kcorbett95/ECE-499-Capstone/CAD/608 bearing Wire Guide Assembly.step

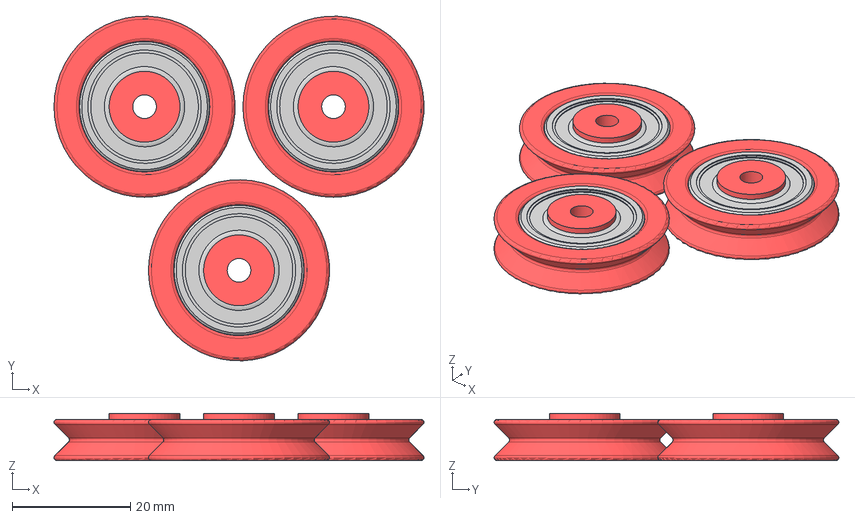
[picture p1: CAD file, 2026-08-06]
CAD/608 bearing Wire Guide Assembly.step
62.7 x 58.4 x 8.00 mm
5972K222_Steel Ball Bearing x 3
608 bearing wire guide x 3
