kcorbett95/ECE-499-Capstone/CAD/Coil Winder Assembly.step

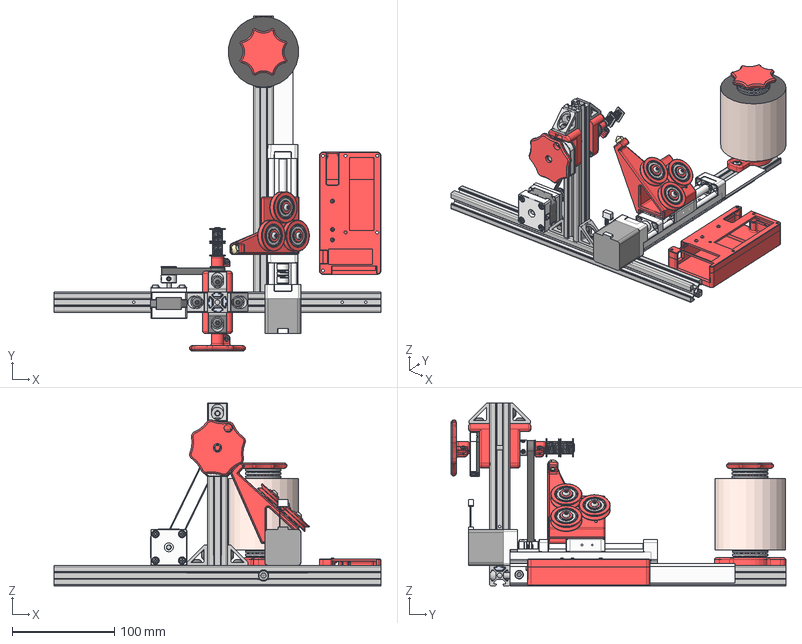
[picture p2: CAD file, 2026-08-06]
CAD/Coil Winder Assembly.step
320.0 x 327.5 x 178.7 mm
5537T518_T-Slotted Framing x 4
M5 2020 Drop Nut x 13
L Bracket
5972K222_Steel Ball Bearing x 2
8x88 shaft
BHCS M5 x 0.8 x 8 Steel Grade 2 Black x 7
¸´¼þ Áã¼þ4^FSK30J-BC- B35(A2°æ±¾£©
Áã¼þ3^FSK30J-BC-B35(A2°æ± ¾£©
76508.A x 2
BSHCS ANSI B18.3.1M - M4x0.7 x 6 Steel Grade 2 Plain x 3
BSHCS ANSI B18.3.1M - M5x0.8 x 8 Steel Grade 2 Plain x 3
BSHCS ANSI B18.3.1M - M6x1 x 20 Steel Grade 2 Plain
AMT-102-Base-REV-K
AMT-102-Top-Cover-REV-I
AMT-Hub-Top-REV-D1
AMT-Hub-Bottom-REV-B
AMT10X-Shaft-Adaptor-REV-E
Receiver-board
Rotor-board-REV F
Transmitter-board AMT10_AMT-102
3684N12_Corrosion-Resistant Aluminum Gt Timing Belt Pulley x 2
DIN 439-2 - M3 x 0.5 Steel 6 Plain x 4
BSHCS ANSI B18.3.1M - M3x0.5 x 12 Steel Grade 2 Plain x 2
DIN 934 - M5 x 0.8 Steel 6 Plain x 2
Bobbin Mount
BSHCS ASME B18.3.1M - M3x0.5 x 6 Steel Grade 2 Plain x 2
Hand Crank
Wire Spool
7806K716_Thrust Ball Bearing x 2
Spool Holder Base
Spool Clamp Adjuster
BHSBHCS ASME B18.3.4M - M5 x 0.8 x 8 Steel Grade 2 Plain x 4
5972K222_Steel Ball Bearing_1 x 3
608 bearing wire guide x 3
Wire Guide Mount
OEI - M4 X 6.35 Stainless Steel Plain x 3
BHSBHCS ASME B18.3.4M - M4 x 0.7 x 12 Steel Grade 2 Plain x 3
BHSBHCS ASME B18.3.4M - M4 x 0.7 x 6 Steel Grade 2 Plain x 4
3695N111_3D Printer Nozzle
6627T39_Stepper Motor
Motor Mount
BSHCS ASME B18.3.1M - M3x0.5 x 8 Steel Grade 2 Plain x 4
280mm GT2 Belt
Enclosure V2
