kcorbett95/ECE-499-Capstone/CAD/Wire Spool Holder (Assembly).step

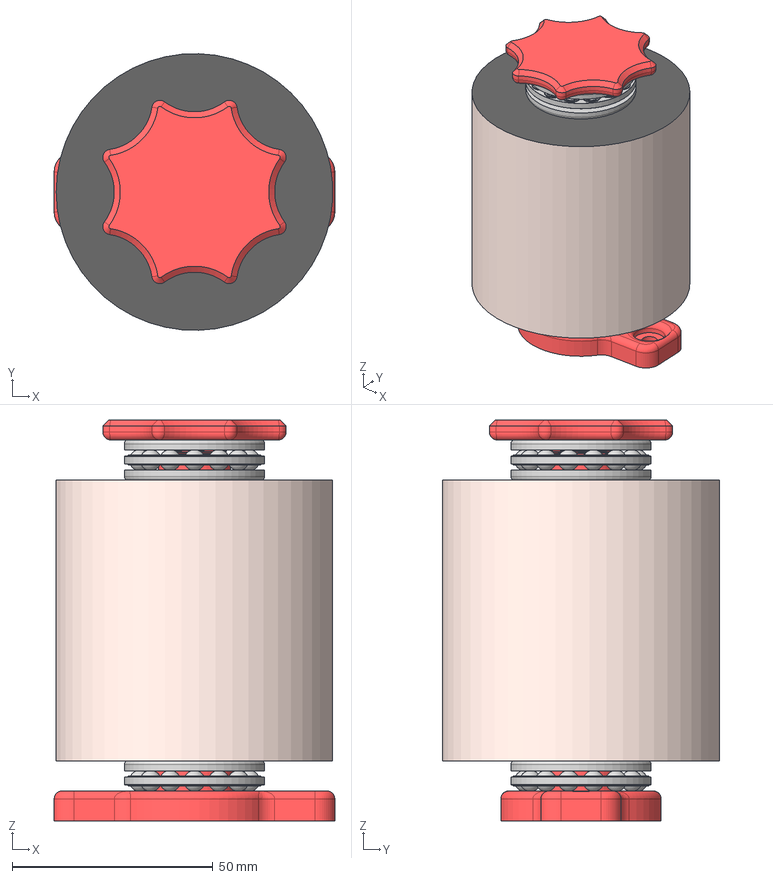
[picture p3: CAD file, 2026-08-06]
CAD/Wire Spool Holder (Assembly).step
70.0 x 69.0 x 100.0 mm
Wire Spool
7806K716_Thrust Ball Bearing x 2
Spool Holder Base
Spool Clamp Adjuster
