kcorbett95/ECE-499-Capstone/3d printed parts/Enclosure V2.3mf

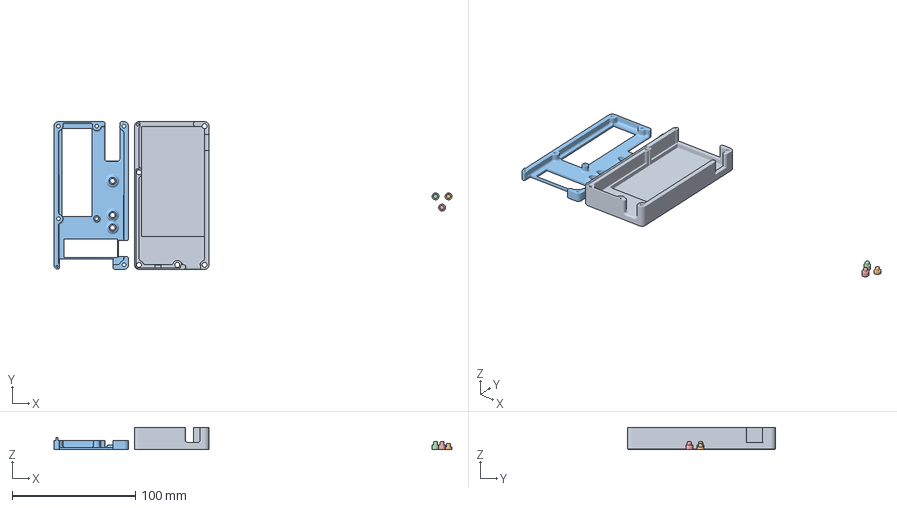
[picture p4: CAD file, 2026-08-06]
3d printed parts/Enclosure V2.3mf
322.4 x 119.6 x 18.2 mm
Bottom
Reset Btn
Top
Start Btn x 2
