kcorbett95/ECE-499-Capstone/CAD/Encoder Same_Sky_AMT102-0048-N2000-S.step

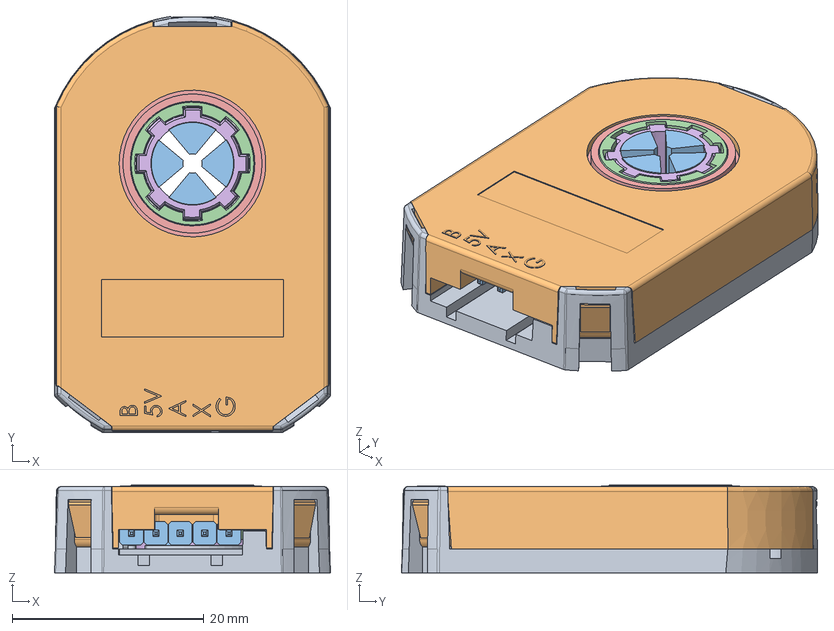
[picture p5: CAD file, 2026-08-06]
CAD/Encoder Same_Sky_AMT102-0048-N2000-S.step
28.8 x 43.4 x 9.15 mm
AMT-102-Base-REV-K
AMT-102-Top-Cover-REV-I
AMT-Sleeve-REV-D_ 2 mm
AMT-Hub-Top-REV-D1
AMT-Hub-Bottom-REV-B
AMT10X-Shaft-Adaptor-REV-E
Receiver-board
Rotor-board-REV F
Transmitter-board AMT10_AMT-102
