kcorbett95/ECE-499-Capstone/3d printed parts/Spool Holder-big-boi.3mf

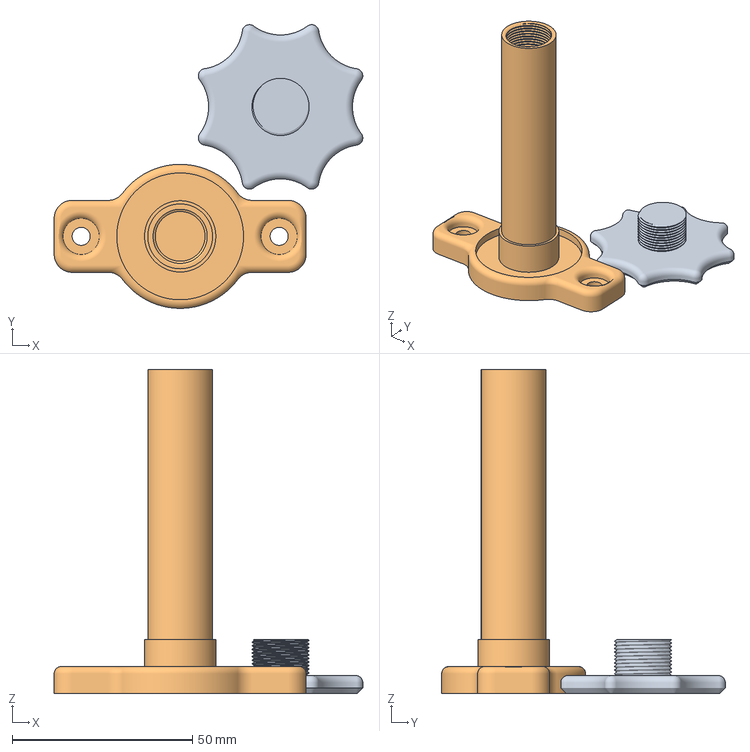
[picture p6: CAD file, 2026-08-06]
3d printed parts/Spool Holder-big-boi.3mf
85.7 x 78.8 x 90.0 mm
