kcorbett95/ECE-499-Capstone/CAD/Hand Crank.step

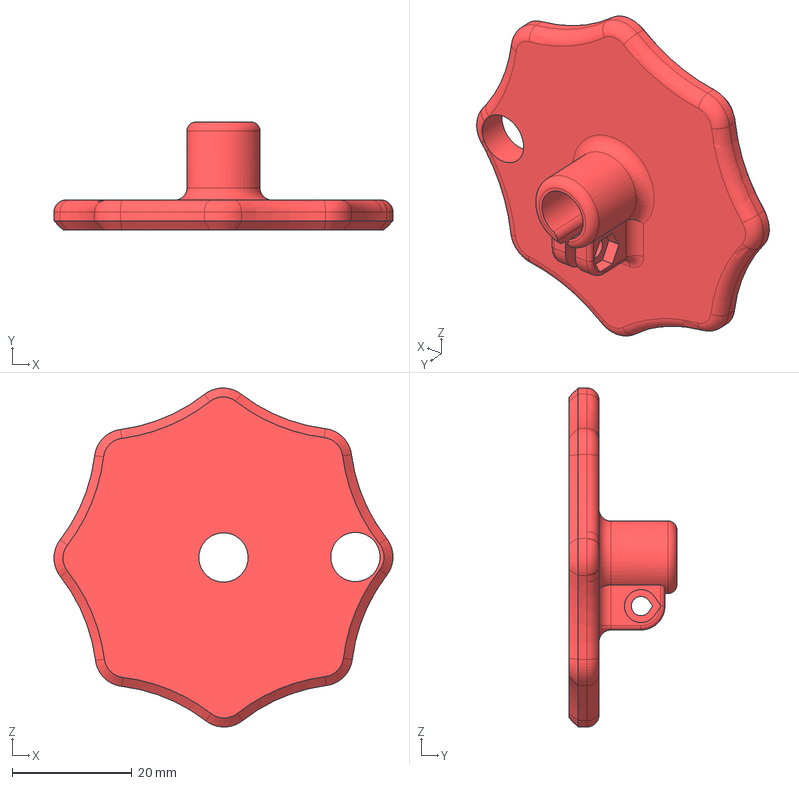
[picture p7: CAD file, 2026-08-06]
CAD/Hand Crank.step
56.5 x 18.0 x 56.5 mm
