kcorbett95/ECE-499-Capstone/3d printed parts/Spool Holder.3mf

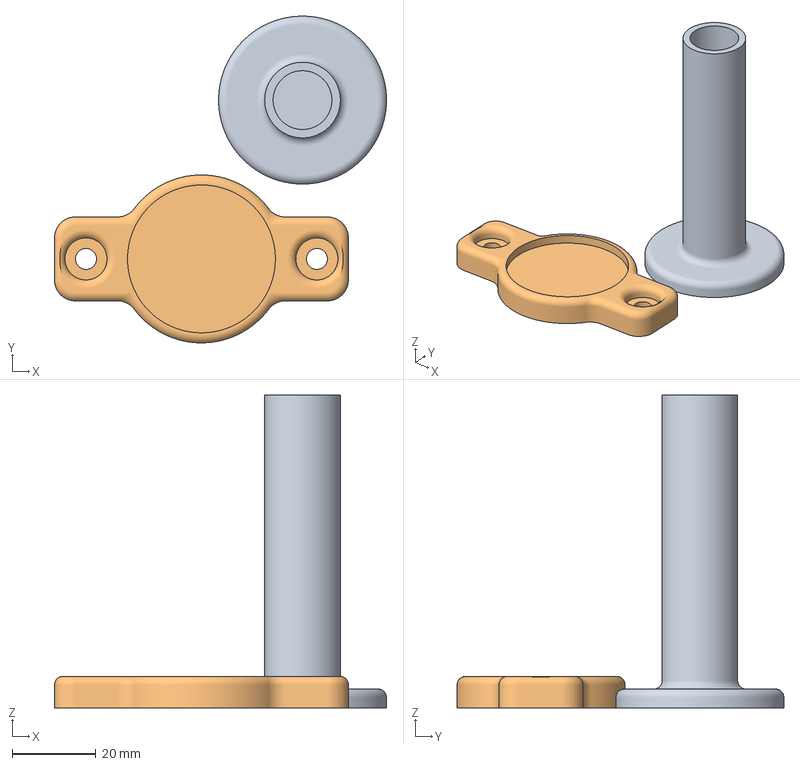
[picture p8: CAD file, 2026-08-06]
3d printed parts/Spool Holder.3mf
79.1 x 77.8 x 74.5 mm
