kcorbett95/ECE-499-Capstone/CAD/FSK30J-50mm.step

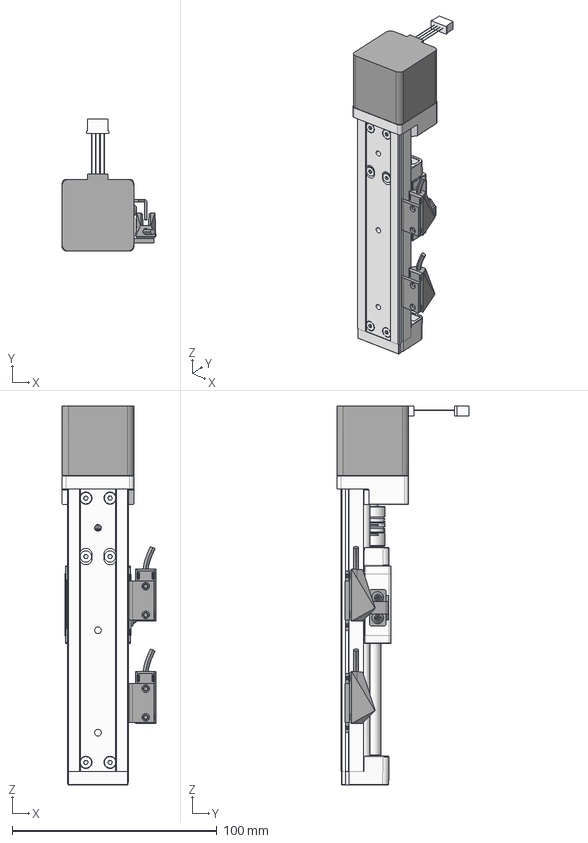
[picture p9: CAD file, 2026-08-06]
CAD/FSK30J-50mm.step
45.8 x 64.5 x 185.1 mm
复件 零件4^FSK30J-BC-B 35(A2版本）
复件 零件7^FSK30J-BC-B 35(A2版本） x 2
复件 零件9^FSK30J-BC-B 35(A2版本）
零件3^FSK30J-BC-B35(A2版本 ）
