kcorbett95/ECE-499-Capstone/3d printed parts/Tensioner.3mf

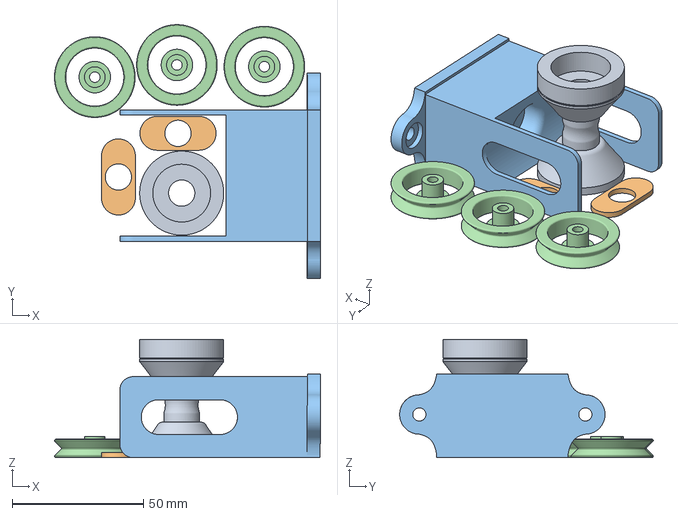
[picture p10: CAD file, 2026-08-06]
3d printed parts/Tensioner.3mf
101.3 x 96.6 x 45.0 mm
Assembly x 4
