kcorbett95/ECE-499-Capstone/CAD/Encoder Bearing Block.step

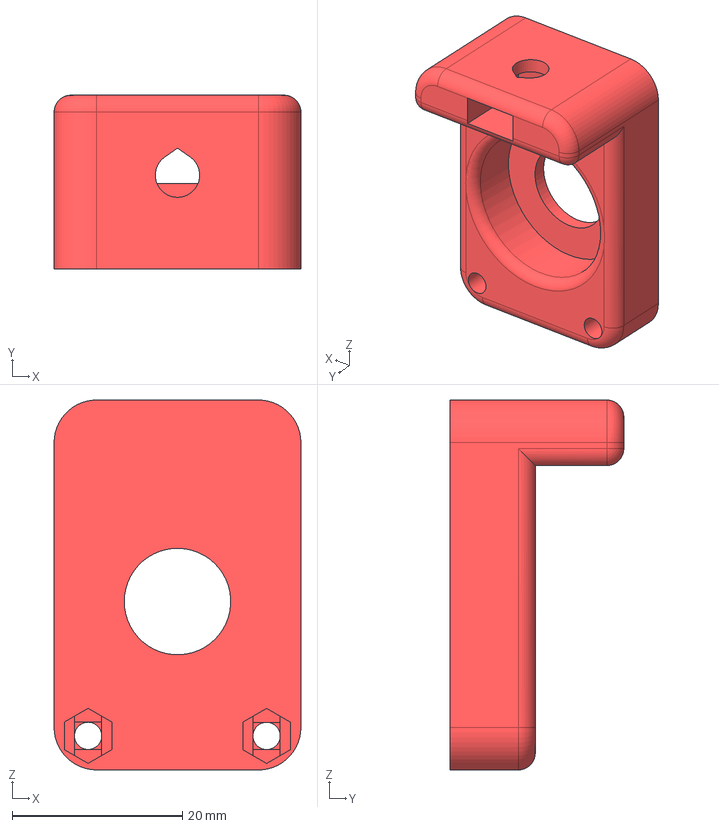
[picture p11: CAD file, 2026-08-06]
CAD/Encoder Bearing Block.step
29.0 x 20.4 x 43.5 mm
