kcorbett95/ECE-499-Capstone/CAD/Spool Clamp Adjuster.step

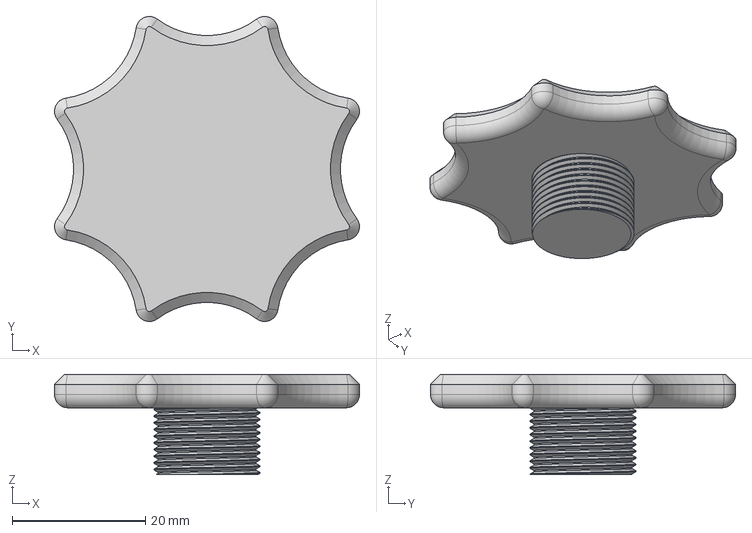
[picture p12: CAD file, 2026-08-06]
CAD/Spool Clamp Adjuster.step
45.7 x 45.7 x 15.0 mm
