kcorbett95/ECE-499-Capstone/CAD/Nozzle.step

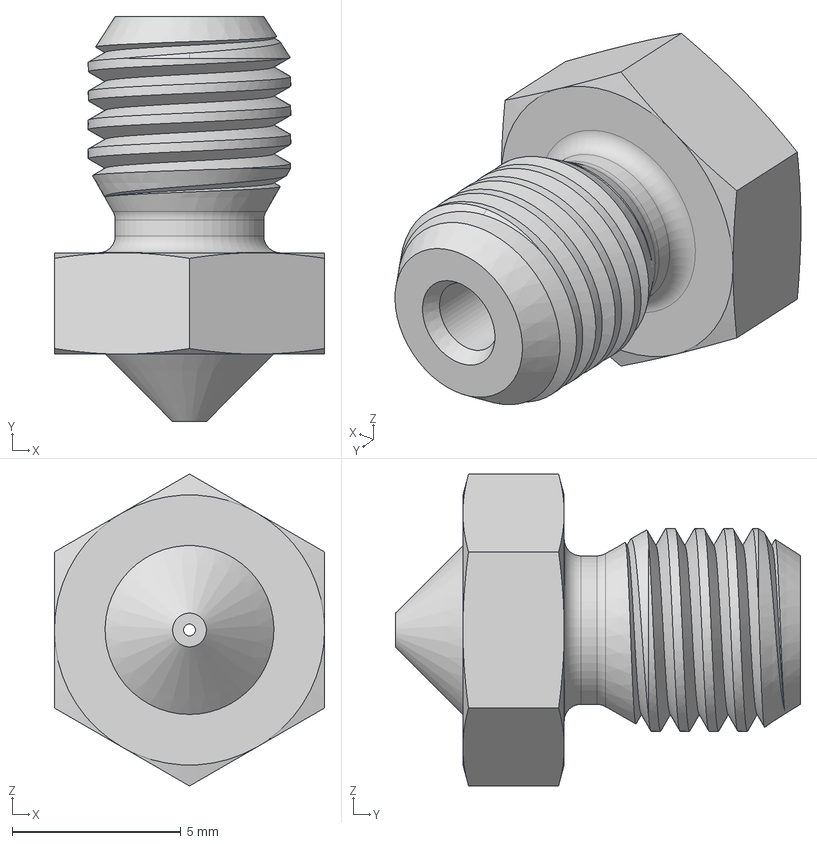
[picture p13: CAD file, 2026-08-06]
CAD/Nozzle.step
8.00 x 12.0 x 9.24 mm
