kcorbett95/ECE-499-Capstone/CAD/Long Wire Guide Mount.step

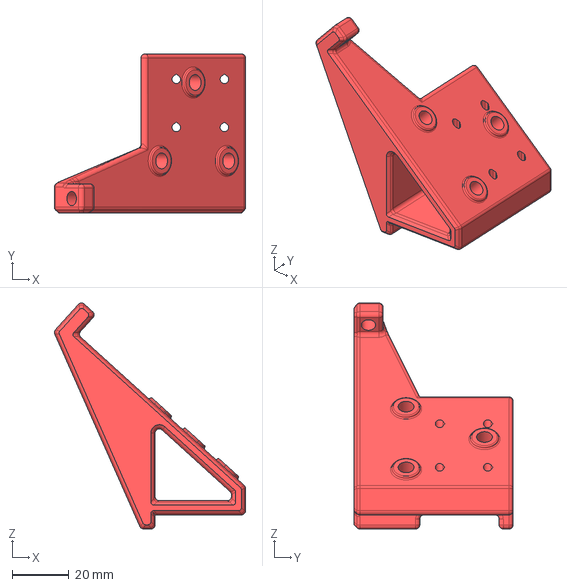
[picture p14: CAD file, 2026-08-06]
CAD/Long Wire Guide Mount.step
67.6 x 56.3 x 79.9 mm
