kcorbett95/ECE-499-Capstone/CAD/Spool Holder Base.step

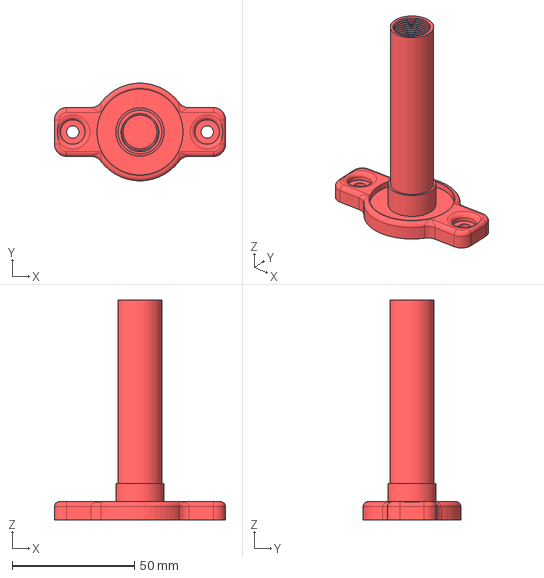
[picture p15: CAD file, 2026-08-06]
CAD/Spool Holder Base.step
70.0 x 39.9 x 90.0 mm
