kcorbett95/ECE-499-Capstone/CAD/Enclosure V2.step

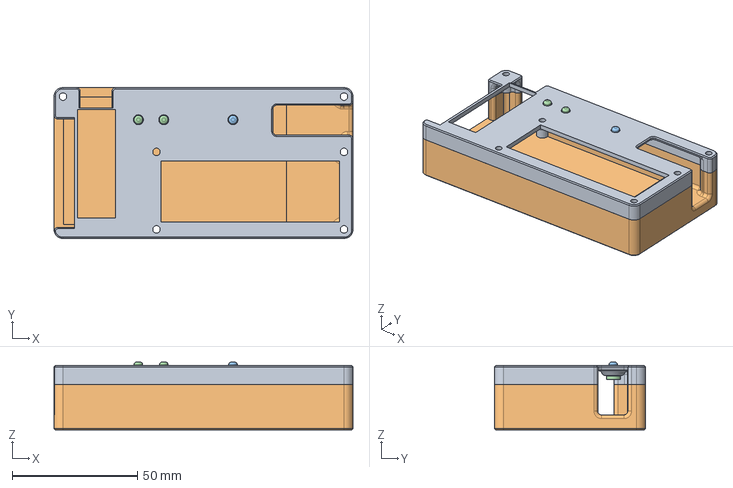
[picture p16: CAD file, 2026-08-06]
CAD/Enclosure V2.step
119.6 x 60.3 x 27.1 mm
