kcorbett95/ECE-499-Capstone/CAD/Bobbin Mount.step

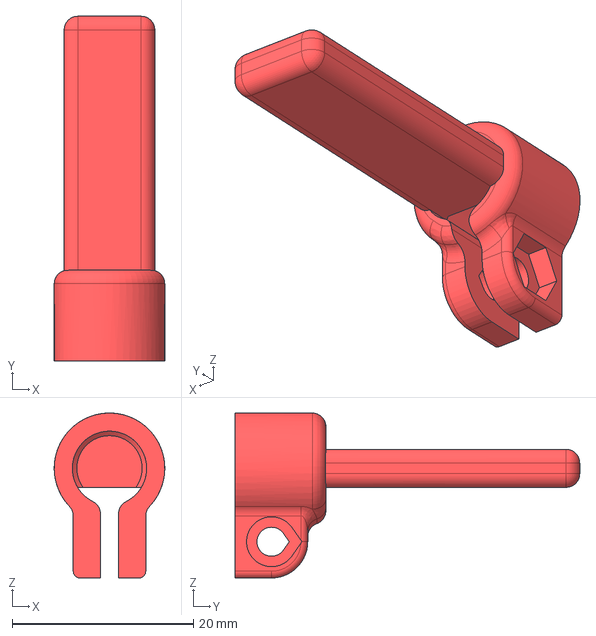
[picture p17: CAD file, 2026-08-06]
CAD/Bobbin Mount.step
12.2 x 38.0 x 18.2 mm
