kcorbett95/ECE-499-Capstone/(list of files, cad)

Other CAD files:
3d printed parts/bobbin.3mf
