kcorbett95/ECE-499-Capstone/PCB/PCB.kicad_pcb

## KiCad design PCB/PCB.kicad_pcb (2026-08-06)

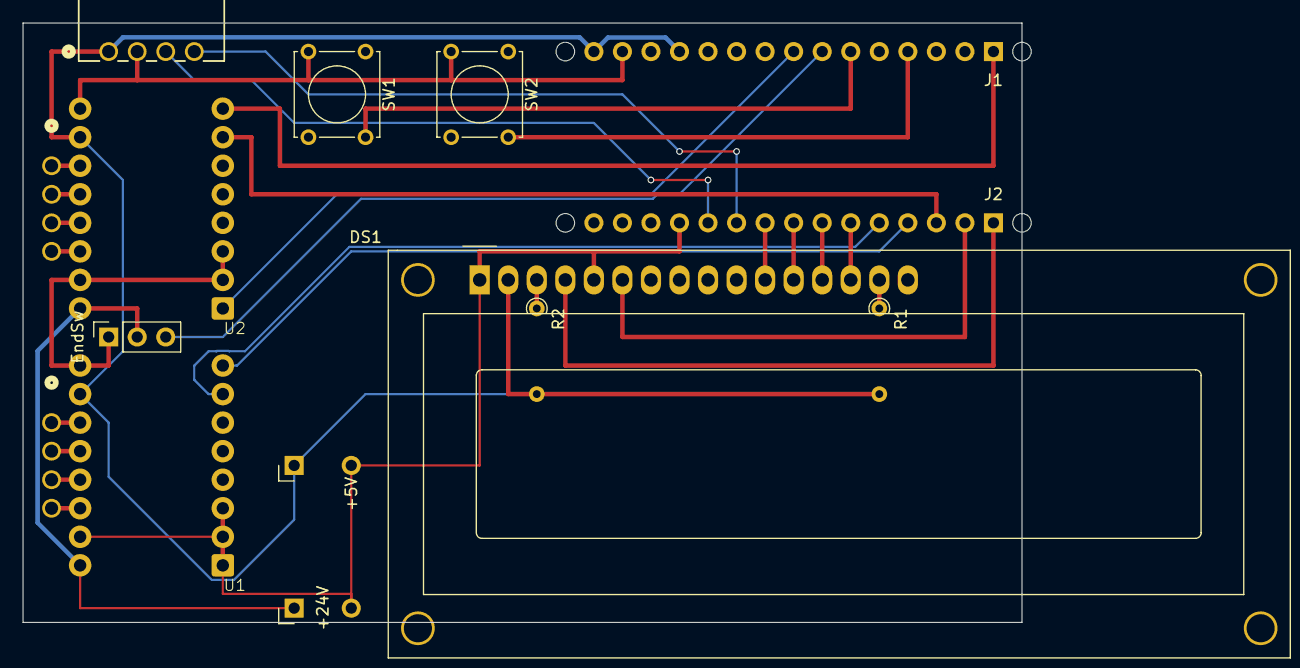
[picture p22: board PCB.kicad_pcb from above]

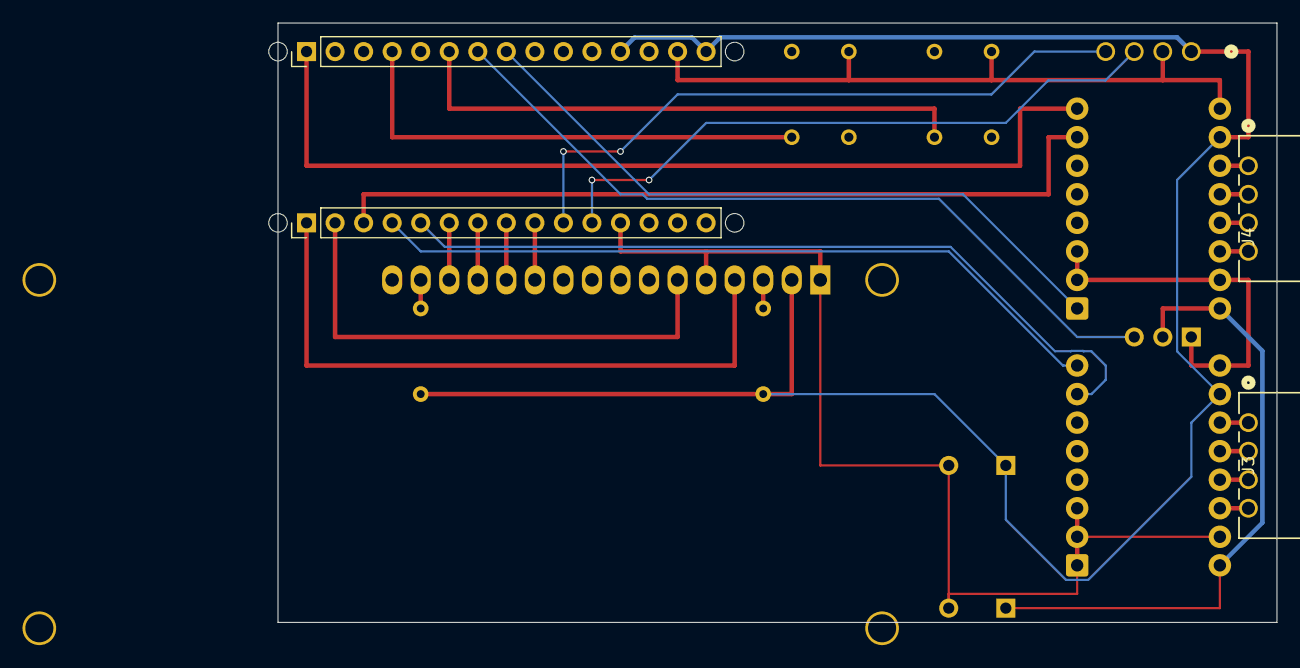
[picture p23: board PCB.kicad_pcb from below]

Board: 2 copper layers, 88.9 x 53.3 mm, 19 parts (4 on the bottom side), 30 nets.

Parts:
+5V, +24V: PinHeader_1x02_P2.54mm_Vertical
DS1: HY1602E; WC1602A
EndSw: PinSocket_1x03_P2.54mm_Vertical
J1: Analog; PinHeader_1x15_P2.54mm_Vertical
J2: Digital; PinHeader_1x15_P2.54mm_Vertical
J3, J4, J5: Conn_01x04_Pin; CONN_70553-xxxx_04_MOL
MH1, MH2, MH3, MH4: MountingHole_65mil
R1: 220; R_Axial_DIN0204_L3.6mm_D1.6mm_P1.90mm_Vertical
R2: 1k2; R_Axial_DIN0204_L3.6mm_D1.6mm_P1.90mm_Vertical
SW1, SW2: SW_DPST; SW_Tactile_Straight_KSL0Axx1LFTR
U1, U2: BTT-TMC2209

Connections:
+5V: +5V.1, DS1.2 (VDD), J1.12, J1.15, J5.1, R1.2, R2.2, U1.10 (VDD), U2.10 (VDD)
+24V: +24V.1, EndSw.2, U1.16 (VM), U2.16 (VM)
/*D3: J2.10, J5.4
/*D5: DS1.12 (D5), J2.8
/*D6: DS1.13 (D6), J2.7
/*D9: J2.4, U1.8 (DIR)
/*D10/SS: J2.3, U2.7 (STEP)
/*D11/MOSI: DS1.6 (E), J2.2
/A0: J1.4, SW2.1
/A2: J1.6, SW1.1
/A3: EndSw.3, J1.7
/A4/SDA: J1.8, U2.1 (EN)
/D2: J2.11, J5.3
/D4: DS1.11 (D4), J2.9
/D7: DS1.14 (D7), J2.6
/D8: J2.5, U1.7 (STEP)
/D12/MISO: DS1.4 (RS), J2.1
/D13/SCK: J1.1, U2.8 (DIR)
/~RESET: J1.13, J2.13
GND: +5V.2, +24V.2, DS1.1 (VSS), DS1.5 (R/W), DS1.16 (LED(-)), EndSw.1, J1.14, J2.12, J5.2, SW1.2, SW2.2, U1.1 (EN), U1.2 (MS1), U1.3 (MS2), U1.9 (GND), U1.15 (GND), U2.2 (MS1), U2.3 (MS2), U2.9 (GND), U2.15 (GND)
unnamed: DS1.15 (LED(+)), R1.1
unnamed: DS1.3 (VO), R2.1
unnamed: J3.1, U1.11 (B2)
unnamed: J3.2, U1.12 (B1)
unnamed: J3.3, U1.13 (A1)
unnamed: J3.4, U1.14 (A2)
unnamed: J4.1, U2.11 (B2)
unnamed: J4.2, U2.12 (B1)
unnamed: J4.3, U2.13 (A1)
unnamed: J4.4, U2.14 (A2)
