kcorbett95/ECE-499-Capstone/include/stepper.h

#ifndef stepper_h
#define stepper_h

/*
/   Stepper Controller Model: TMC2209
/   Pinout:
/       P0 = Enable
/       P1 = MS1 (MircoStep Resolution)
/       P2 = MS2 (MircoStep Resolution)
/       P3 = PDN
/       P4 = PDN
/       P5 = CLK (Tie to GND for internal clock)
/       P6 = STEP (Single Step Pulse)
/       P7 = DIR (Step Direction)
/       P8 = VM (Stepper Motor Reference Voltage 24V)
/       P9 = GND
/       P10 = Motor A2
/       P11 = Motor A1
/       P12 = Motor B1
/       P13 = Motor B2
/       P14 = Motor A2
/       P15 = VDD   (5V)
/       P16 = GND
/   MS1/2 Resolution:
/       00 = 1/8
/       01 = 1/32
/       10 = 1/64
/       11 = 1/16
/   0.01mm linear travel per step
/   LINEAR_RES 0.00106 measured per MicroStep with MS1/2 = 00
*/

#include <Arduino.h>

class stepper{
    public:

    stepper(int Step_Pin, int Direction_Pin){
        _stepPin = Step_Pin;
        _dirPin = Direction_Pin;
    }

    void enable(){
        pinMode(_stepPin, OUTPUT);
        pinMode(_dirPin, OUTPUT);
    }

    void step(int direction, int num_step){
        digitalWrite(_dirPin, direction ? HIGH : LOW);
        delayMicroseconds(5);
        for(int i = 0; i < num_step; i++){
            digitalWrite(_stepPin, HIGH);
            delayMicroseconds(160);
            digitalWrite(_stepPin, LOW);
            delayMicroseconds(160);
        }
    }

    private:
    int _stepPin;
    int _dirPin;
};

#endif
