kcorbett95/ECE-499-Capstone/(commit log)

2026-06-21 Encoder 1.0
    Encoder working with simple counter and revolution increment/decrement. Will improve functionality and tweak areas at a later point.
2026-06-21 Cleanup
    Cleaned up the encoder section a touch
2026-06-21 LCD init and working, with wiring
2026-06-21 Initial Stepper-Linear
    Initial Stepper_Linaer push. Added library and created class for stepper motor
2026-06-22 Encoder printing to LCD, Working
2026-06-22 LCD wiring table update
2026-06-22 Linear Actuator to Encoder function
2026-06-22 Working Linear Drive on Encoder Reference
2026-06-22 Cleaned up encoder related files
2026-06-24 Added Nano Pin Connection Table, DIR pin set to output
2026-06-26 Adjusted pinout and changed board type
2026-06-26 Homing switch working
2026-06-26 back-and-forth was working, but then fried stepper drivers. no idea why
2026-07-07 jog buttons working, added tweaking variables
2026-07-13 WIP - Linear Stepper Rework
    [main.cpp]
2026-07-13 Linear Stepper working
2026-07-13 Home button working, now stops at correct number of turns
    [main.cpp]
2026-07-14 Tuning wire guide behaviour with rotary drive
2026-08-06 Added CAD
    [608 bearing Wire Guide Assembly.step, 608 bearing guide.3mf, Bobbin Mount.step, Coil Winder Assembly.step, Enclosure V2.3mf, Enclosure V2.step, Encoder Bearing Block.step, Encoder Same_Sky_AMT102-0048-N2000-S.step]
